levykrak/ALDL_OLED/ALDL/BGF/wskaznik_obliczenia.bmp

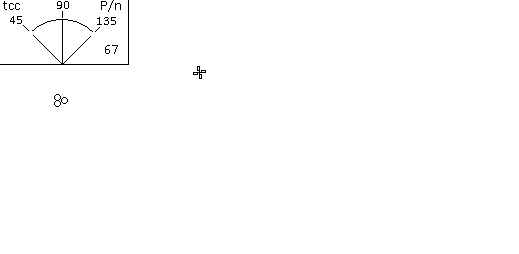
ALDL/BGF/wskaznik_obliczenia.bmp
