levykrak/ALDL_OLED/(list of files, cad)

Other CAD files:
ALDL/aldl_transmisja_UDR.obj
ALDL_kopia/aldl_transmisja_UDR.obj
ALDL/aldl_kopia.obj
ALDL_kopia/aldl_dziala.obj
ALDL/aldl.obj
ALDL_kopia/aldl_kopia_udr_oled_kopia.obj
ALDL/aldl_kopia_udr_oled_kopia.obj
ALDL_kopia/suma_kontrolna.obj
ALDL/suma_kontrolna.obj
ALDL_kopia/aldl.obj
ALDL/rs232buffer.obj
ALDL_kopia/aldl_mode0_mode1.obj
ALDL/aldl_kopia_udr_oled.obj
ALDL_kopia/rs232buffer.obj
ALDL/aldl_kopia_udr.obj
ALDL_kopia/aldl_kopia_udr_oled.obj
ALDL/aldl_dziala.obj
ALDL_kopia/aldl_kopia.obj
ALDL/aldl_mode0_mode1.obj
ALDL_kopia/aldl_kopia_udr.obj
