levykrak/ALDL_OLED/ALDL-datalogger.pdf

# ALDL interface

# ALDL header

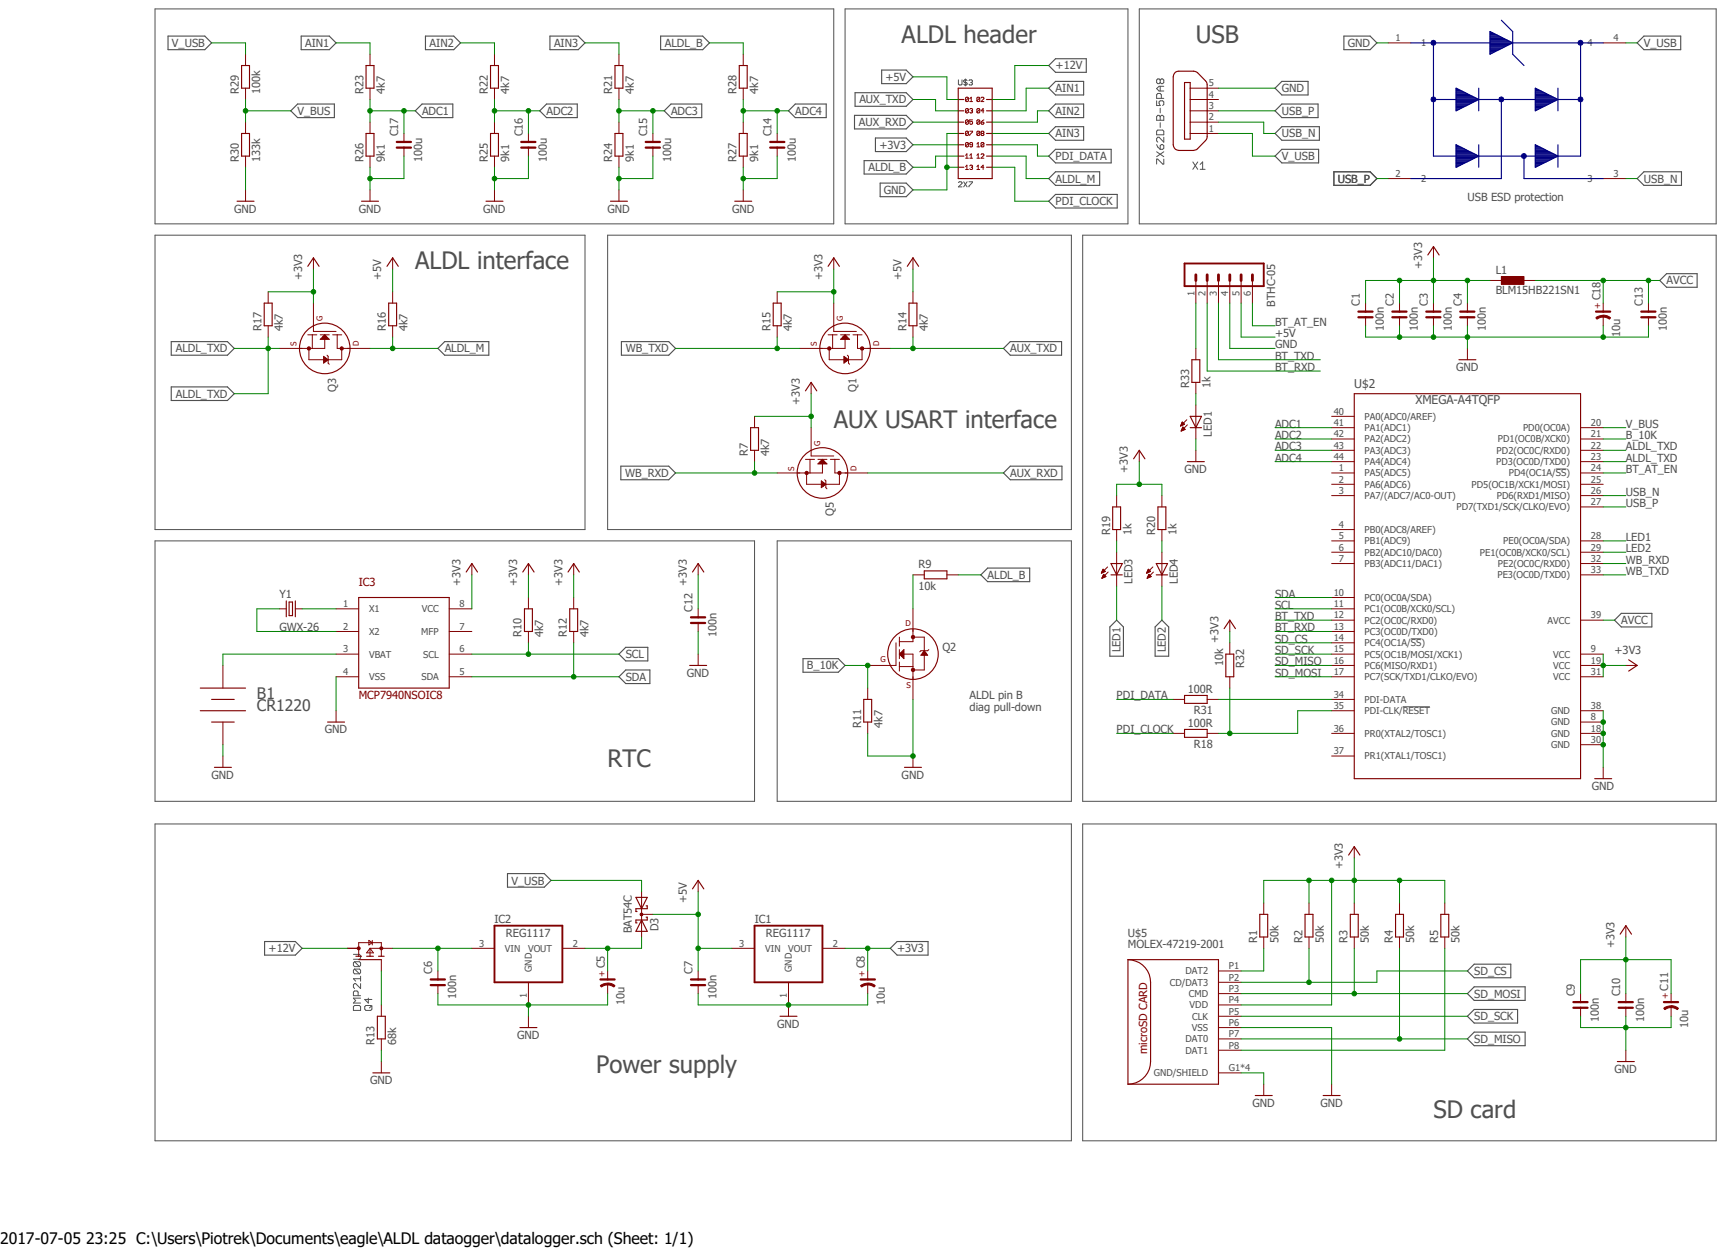
[picture p7: page 1]

2017-07-05 23:25 C:\Users\Piotrek\Documents\eagle\ALDL dataogger\datalogger.sch (Sheet: 1/1)
