levykrak/ALDL_OLED/kicad/aldl.kicad_pcb

## KiCad design kicad/aldl.kicad_pcb (2019-04-29)

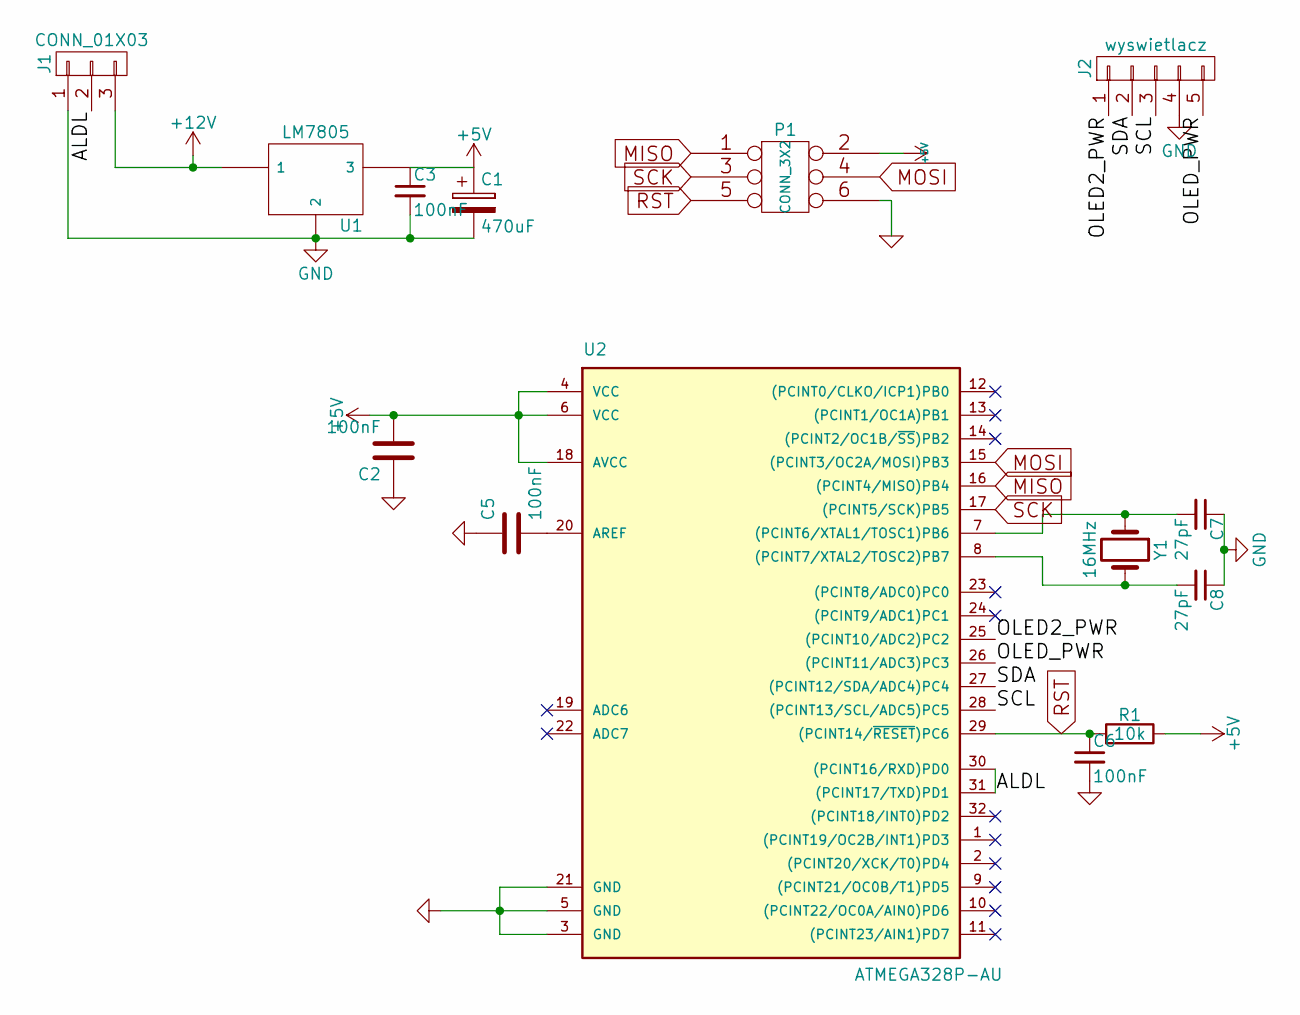
[picture p8: schematic aldl.sch]

Parts:
C1: 470uF; CP_Elec_10x10
C2, C3, C5, C6: 100nF; C_1206
C7, C8: 27pF; C_1206
J1: CONN_01X03; bornier3
J2: wyswietlacz; Wafer_Vertical15x5.8x7RM2.5-5
P1: CONN_3X2; Pin_Header_Straight_2x03_Pitch2.54mm
R1: 10k; R_1206_HandSoldering
U1: LM7805; TO-252-2_Rectifier
U2: ATMEGA328P-AU; TQFP-32_7x7mm_Pitch0.8mm
Y1: 16MHz; Crystal_SMD_HC49-SD

Connections:
+5V: C1.1, C2.2, C3.1, P1.2, R1.1, U1.3, U2.4 (VCC), U2.6 (VCC), U2.18 (AVCC)
+12V: J1.3, U1.1
/ALDL: J1.2, U2.30 ((PCINT16/RXD)PD0), U2.31 ((PCINT17/TXD)PD1)
/OLED2_PWR: J2.1, U2.25 ((PCINT10/ADC2)PC2)
/OLED_PWR: J2.5, U2.26 ((PCINT11/ADC3)PC3)
/SCL: J2.3, U2.28 ((PCINT13/SCL/ADC5)PC5)
/SDA: J2.2, U2.27 ((PCINT12/SDA/ADC4)PC4)
GND: C1.2, C2.1, C3.2, C5.1, C6.2, C7.1, C8.1, J1.1, J2.4, P1.6, U1.2, U2.3 (GND), U2.5 (GND), U2.21 (GND)
MISO: P1.1, U2.16 ((PCINT4/MISO)PB4)
MOSI: P1.4, U2.15 ((PCINT3/OC2A/MOSI)PB3)
unnamed: C5.2, U2.20 (AREF)
unnamed: C7.2, U2.7 ((PCINT6/XTAL1/TOSC1)PB6), Y1.1
unnamed: C8.2, U2.8 ((PCINT7/XTAL2/TOSC2)PB7), Y1.2
RST: C6.1, P1.5, R1.2, U2.29 ((PCINT14/~RESET~)PC6)
SCK: P1.3, U2.17 ((PCINT5/SCK)PB5)

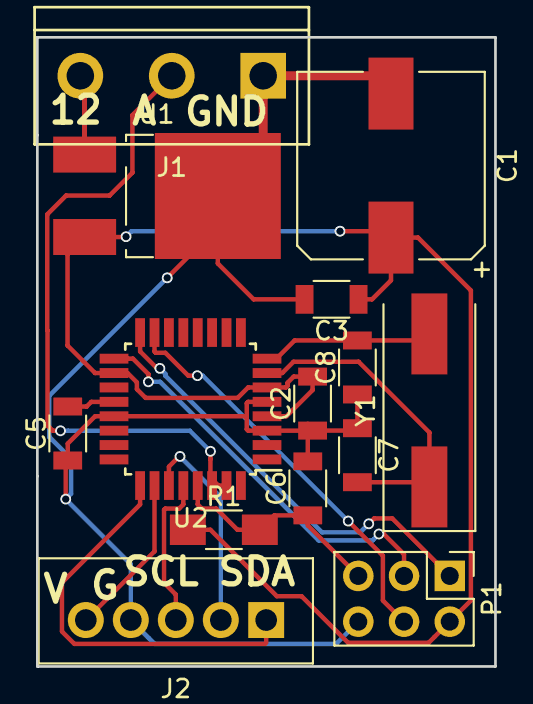
[picture p9: board aldl.kicad_pcb from above]

Board: 2 copper layers, 25.5 x 35.0 mm, 14 parts (0 on the bottom side), 15 nets.
