levykrak/ALDL_OLED/ALDL/rs232buffer.bas

'-----------------------------------------------------------------------------------------
'name                     : rs232buffer.bas
'copyright                : (c) 1995-2005, MCS Electronics
'purpose                  : example shows the difference between normal and buffered
'                           serial INPUT
'micro                    : Mega48
'suited for demo          : yes
'commercial addon needed  : no
'-----------------------------------------------------------------------------------------

$regfile = "m8def.dat"                                      ' specify the used micro
$crystal = 10000000                                         ' used crystal frequency
$baud = 9600                                                ' use baud rate
$hwstack = 32                                               ' default use 32 for the hardware stack
$swstack = 10                                               ' default use 10 for the SW stack
$framesize = 40                                             ' default use 40 for the frame space

'first compile and run this program with the line below remarked
Config Serialin = Buffered , Size = 70


'Dim Nm As String * 1
Dim Nm As Byte * 70
Dim Suma_kontrolna As Byte , I As Byte , Odp As Bit

'Const Aldl_bodysize_0 = 67                                  'wielkosc dla mode 0
'Const Aldl_bodysize_1 = 67                                  'wielkosc dla mode 0


'the enabling of interrupts is not needed for the normal serial mode
'So the line below must be remarked to for the first test
Enable Interrupts

Wait 5
Print "Start"
Do
   'get a char from the UART
   For I = 0 To 70
   If Ischarwaiting() = 1 Then                              'was there a char?
      Nm = Waitkey()
      'Print Nm                                              'print it

   Else
      'Nm = "0"
      'Suma_kontrolna = String
   End If
   Next I

   Suma_kontrolna = Suma_kontrolna + Nm
      'Print Suma_kontrolna

   Suma_kontrolna = Suma_kontrolna - 256
   Print "suma: " ; Suma_kontrolna




   Wait 5                                                   'wait 1 second
Loop

'You will see that when you slowly enter characters in the terminal emulator
'they will be received/displayed.
'When you enter them fast you will see that you loose some chars

'NOW remove the remarks from line 11 and 18
'and compile and program and run again
'This time the chars are received by an interrupt routine and are
'stored in a buffer. This way you will not loose characters providing that
'you empty the buffer
'So when you fast type abcdefg, they will be printed after each other with the
'1 second delay

'Using the CONFIG SERIAL=BUFFERED, SIZE = 10 for example will
'use some SRAM memory
'The following internal variables will be generated :
'_Rs_head_ptr0   BYTE , a pointer to the location of the start of the buffer
'_Rs_tail_ptr0   BYTE , a pointer to the location of tail of the buffer
'_RS232INBUF0 BYTE ARRAY , the actual buffer with the size of SIZE
